shidrath/Robo-PLow/MaximumYellow_L3G3/main/Ultrasonic.h

#ifndef Ultrasonic_h
#define Ultrasonic_h

#include "Arduino.h"

class Ultrasonic
{
  public:
    Ultrasonic(int trigPin, int echoPin);
    int read();
  private:
    int _trigPin, _echoPin;
    float duration, dist;
};

#endif
